valcesch/AstroTracker/hardware/AstroTracker_v06/STACKUP_astrotracker_v06_rev2.png

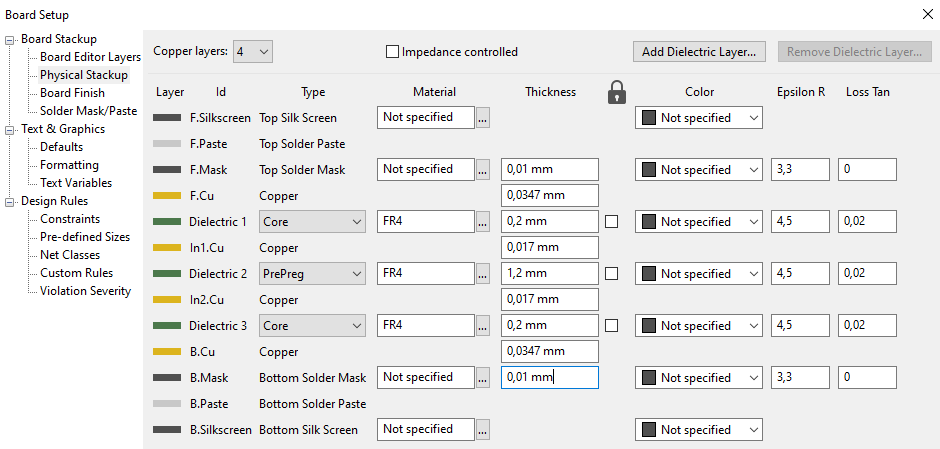
hardware/AstroTracker_v06/STACKUP_astrotracker_v06_rev2.png
