valcesch/AstroTracker/hardware/AstroTracker_v06/BOM_astrotracker_v06_rev2.xlsx

Designator | Manufacturer | Manufacturer reference | Value | Description | Package | Quantity | Unit cost | Total cost | Link
U1 | Guerrilla RF | GRF6011 | GRF6011 | RF Switch ICs .1-3.8GHz SPDT IL .43dB | SMD | 1 | 2.39 | 2.39 | https://www.mouser.ch/ProductDetail/Guerrilla-RF/GRF6011?qs=YCa%2FAAYMW03B6wCBu6EtGA%3D%3D
U2 | ublox | MAX-M10S | MAX-M10S | ublox GNSS receiver | SMD module | 1 | 20.67 | 20.67 | https://www.digikey.ch/de/products/detail/u-blox/MAX-M10S-00B/15712906
U3 | Astrocast | AST50147-00 | AST50147-00 | Astronode S | SMD module | 1 | 37 | 37
U4 | Astrocast | AST50127-00 | AST50127-00 | Astrocast antenna patch | Through hole pin | 1 | 5 | 5
U5 | Microchip | ATSAMD21G18A-M | ATSAMD21G18A-M | SAMD21 MCU | SMD | 1 | 3.91 | 3.91 | https://www.mouser.ch/ProductDetail/Microchip-Technology-Atmel/ATSAMD21G18A-MUT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
U6 | Microchip | MCP1700-3302E_SOT23 | MCP1700-3302E_SOT23 | Low Quiescent Current LDO | SMD | 1 | 0.465 | 0.465 | https://ww1.microchip.com/downloads/en/DeviceDoc/MCP1700-Low-Quiescent-Current-LDO-20001826E.pdf
U7 | Texas Instruments | TPL5010 | TPL5010 | Nano-Power System Timer With Watchdog Function | SMD | 1 | 1.17 | 1.17 | https://www.ti.com/lit/ds/symlink/tpl5010.pdf
C10,C11 | N.A. | N.A. | 22pF | 22pF 10% 25V Ceramic Capacitor X6S 0603 (1608 Metric) | 0603 | 2 | 0 | 0
C16,C19,C20 | N.A. | N.A. | 27pF | 27pF 10% 16V Ceramic Capacitor X7R 0402 (1005 Metric) | 402 | 3 | 0 | 0
C17,C18 | N.A. | N.A. | 100pF | 100pF 10% 16V Ceramic Capacitor X7R 0402 (1005 Metric) | 402 | 2 | 0 | 0
C8 | N.A. | N.A. | 0.1uF | 0.1uF 10% 25V Ceramic Capacitor X6S 0603 (1608 Metric) | 0603 | 1 | 0 | 0
C4,C6,C7,C12,C14,C15 | N.A. | N.A. | 1uF | 1uF 10% 25V Ceramic Capacitor X6S 0603 (1608 Metric) | 0603 | 6 | 0 | 0
C1,C2,C3,C13 | N.A. | N.A. | 10uF | 10uF 10% 10V Ceramic Capacitor X6S 0603 (1608 Metric) | 0603 | 4 | 0 | 0
R1,R2,R14 | N.A. | N.A. | 2.2k | 2.2 kOhms 1% 0.01W, 1/10W Chip Resistor 0603 (1608 Metric) Thick Film | 0603 | 3 | 0 | 0
R6,R7 | N.A. | N.A. | 22 | 22 Ohms 1% 0.01W, 1/10W Chip Resistor 0603 (1608 Metric) Thick Film | 0603 | 2 | 0 | 0
R12 | N.A. | N.A. | 47k | 47 kOhms 1% 0.01W, 1/10W Chip Resistor 0603 (1608 Metric) Thick Film | 0603 | 1 | 0 | 0
R11 | N.A. | N.A. | 100k | 100 kOhms 1% 0.01W, 1/10W Chip Resistor 0603 (1608 Metric) Thick Film | 0603 | 1 | 0 | 0
R3,R4,R9,R10,R13 | N.A. | N.A. | 1M | 1 MOhms 1% 0.01W, 1/10W Chip Resistor 0603 (1608 Metric) Thick Film | 0603 | 2 | 0 | 0
D2 | Vishay | VLMG1300-GS08 | VLMG1300-GS08 | Yellow LED 20mA 0603 (1608 Metric) Thick Film | 0603 | 1 | 0.29 | 0.29
D1 | Onsemi / Fairchild | MBR0530 | MBR0530 | Schottky Dioden & Gleichrichter Schottky diode 30V/0.5A | SOD-123-2 | 1 | 0.317 | 0.317 | https://www.mouser.ch/ProductDetail/onsemi-Fairchild/MBR0530?qs=VOMQJJE%252BBNniwJKcE3T43Q%3D%3D
Q1,Q3 | Vishay | SI2329DS-T1-GE3 | SI2329DS | P-Channel 8V 6A STO-23 | SOT-23 | 2 | 0.6 | 1.2
Q2 | Vishay | SI2342DS-T1-GE3 | SI2342DS | N-Channel 8V 6A STO-23 | SOT-23 | 1 | 0.6 | 0.6
SW2 | Diptronics | MPTFP2-V-T/R | MPTFP2-V-T/R | Tactile Switches | SMD | 1 | 0.7 | 0.7 | https://www.mouser.ch/ProductDetail/Diptronics/MPTFP2-V-T-R?qs=sGAEpiMZZMsqIr59i2oRckjEZjc1TSZQ1WwpmngjOl0%3D
J1 | Molex | 47346-0001 | 47346-0001 | USB Connectors MICRO USB B RECPT BTTM MOUNT ASSY | SMD | 1 | 1.08 | 1.08 | https://www.mouser.ch/ProductDetail/Molex/47346-0001?qs=c2CV6XM0DweJBWaSeyWeCw%3D%3D
J2 | SparkFun | PRT-08612 | PRT-08612 | SparkFun Accessories JST Right Angle Connector - White | SMD | 1 | 1 | 1 | https://www.mouser.ch/ProductDetail/SparkFun/PRT-08612?qs=WyAARYrbSnbBv6rnEOuhcA%3D%3D
Y1 | Abracon | ABS07-32.768KHZ-T | ABS07-32.768KHZ-T | Crystals 32.768K HZ 12.5PF SMD | SMD | 1 | 0.6 | 0.6 | https://www.mouser.ch/ProductDetail/ABRACON/ABS07-32.768KHZ-T?qs=3SpAxaLJ01g8GJWeO3sA3Q%3D%3D
