valcesch/AstroTracker/(threads)

Thread 1 (2023-10-12):

How to compile and upload firmware for AstroTracker V0.6 REV2 (MiniTracker)

Joaliasbarb, 2023-10-12:
Hello,

We are trying to compile and flash the firmware on a MiniTracker harwdare using Arduino IDE.
Unfortunately, the board description files for this hardware is not included in the repo and we didn't managed to create them. We're left with a lot of questions on how to proceed.

Could you provide us with some guidance on the necessary steps to perform ?

Cheers !

valcesch, 2023-10-12:
Hello Joaliasbarb,

When using the Arduino IDE, you need to select the Adafruit Feather M0. You will probably have to burn the bootloader for this platform (also with the Arduino IDE).

Hope this will solve your issue !

Closed 2023-11-10.
