valcesch/AstroTracker/hardware/AstroTracker_v06/SCHEMATIC_astrotracker_v06_rev2.pdf

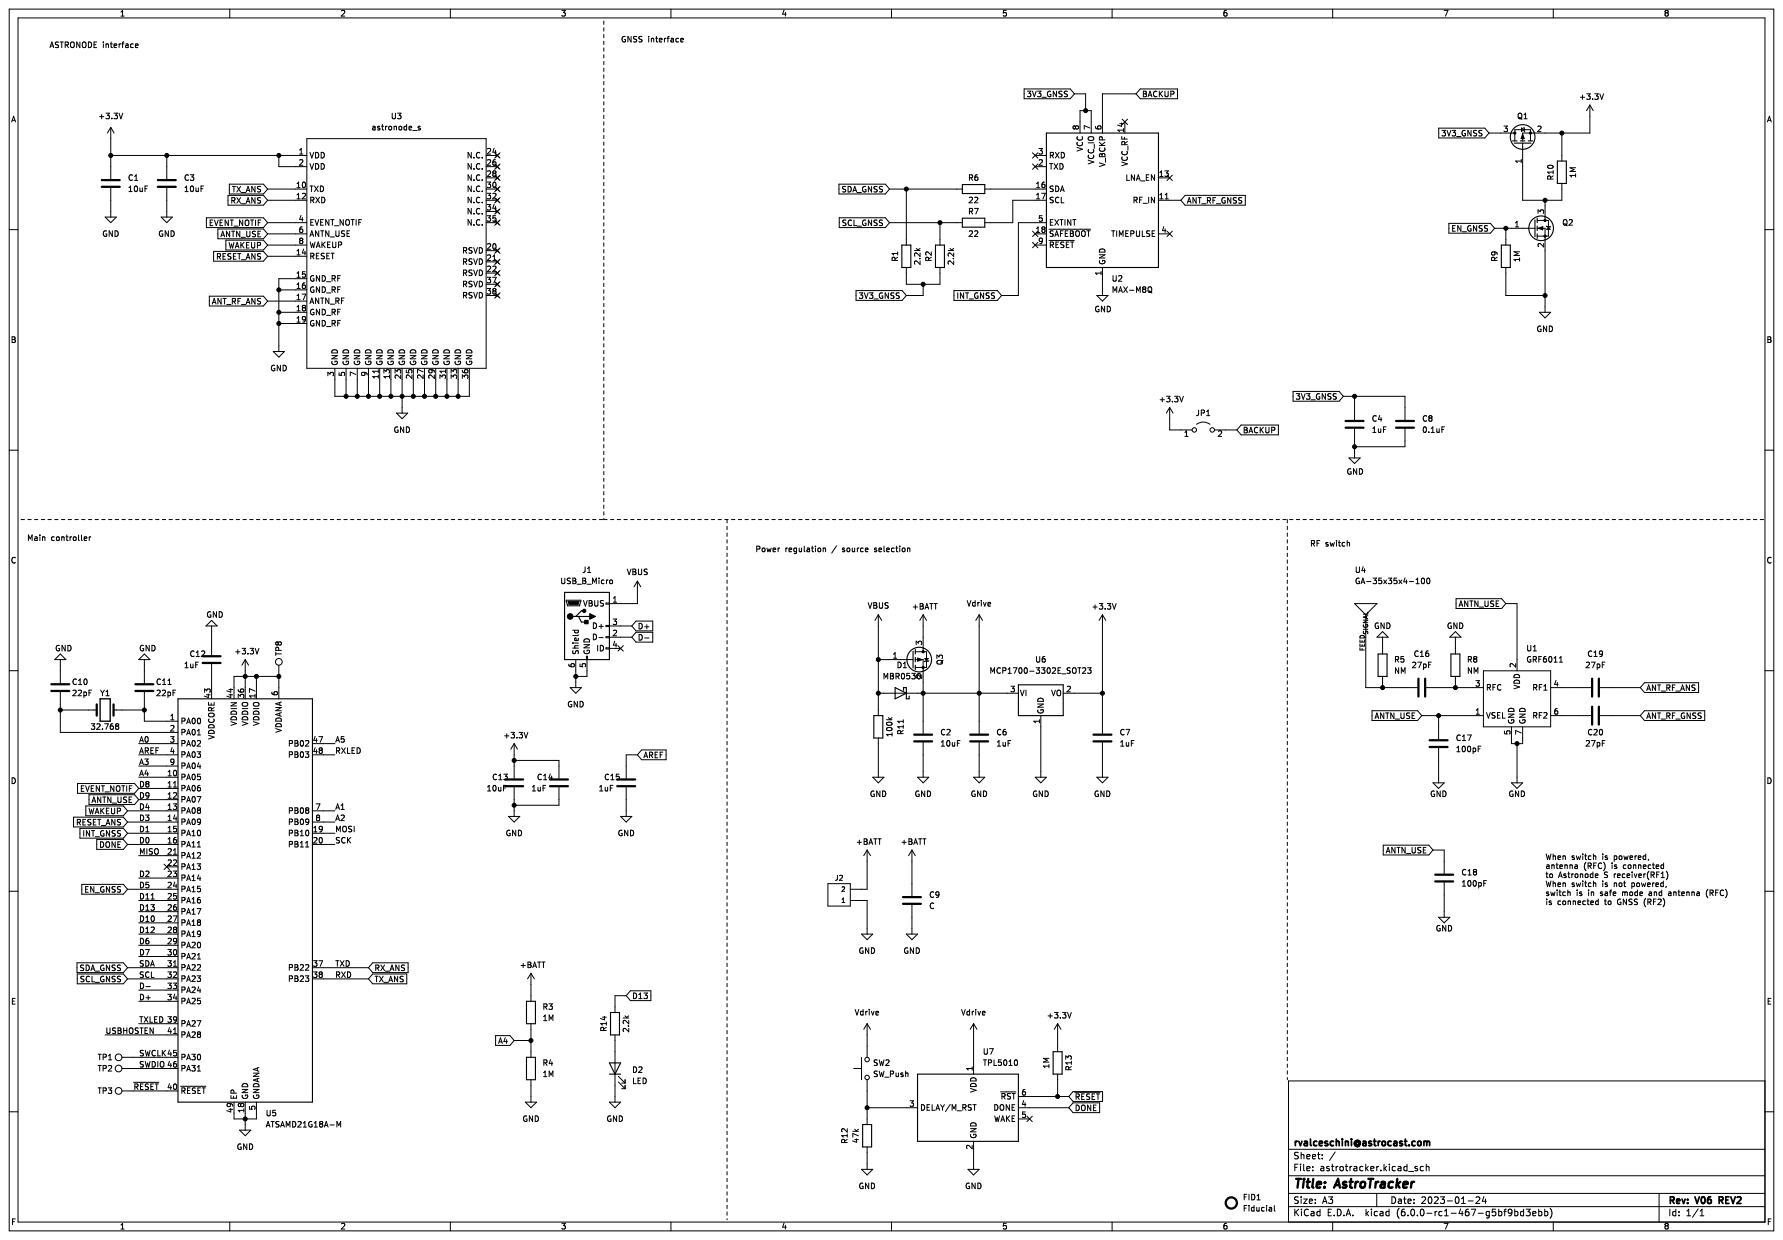
[picture p6: page 1]
