valcesch/AstroTracker/firmware/AstroTracker/src/core/sm/sm.cpp

/* sm.c - State machine handling code
 *
 * Copyright (C) 2018 Arribada
 *
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
 * You should have received a copy of the GNU General Public License
 * along with this program.  If not, see <https://www.gnu.org/licenses/>.
 */

#include "sm.h"
#include <limits.h>

#define FUNCTION_NOT_SET (INT_MAX)

void sm_init(sm_handle_t *handle, sm_state_func_t *state_table)
{
    handle->state_function_lookup_table = state_table;
    handle->last_state = FUNCTION_NOT_SET;
    handle->current_state = FUNCTION_NOT_SET;
    handle->next_state = FUNCTION_NOT_SET;
    handle->first_time_running = true;
}

void sm_tick(sm_handle_t *handle)
{
    handle->state_function_lookup_table[handle->current_state](handle);

    handle->first_time_running = false;

    if (handle->current_state != handle->next_state)
    {
        handle->first_time_running = true;
        handle->last_state = handle->current_state;
        handle->current_state = handle->next_state;
    }
};

bool sm_is_first_entry(const sm_handle_t *handle)
{
    return handle->first_time_running;
}

bool sm_is_last_entry(const sm_handle_t *handle)
{
    return sm_get_next_state(handle) != sm_get_current_state(handle);
}

void sm_set_next_state(sm_handle_t *handle, int state)
{
    if (FUNCTION_NOT_SET == handle->current_state)
        handle->current_state = state;

    handle->next_state = state;
}

int sm_get_last_state(const sm_handle_t *handle)
{
    return handle->last_state;
}

int sm_get_current_state(const sm_handle_t *handle)
{
    return handle->current_state;
}

int sm_get_next_state(const sm_handle_t *handle)
{
    return handle->next_state;
}
