valcesch/AstroTracker/firmware/AstroTracker/src/syshal/pmu/syshal_pmu.cpp

/******************************************************************************************
 * File:        syshal_pmu.cpp
 * Author:      valcesch
 * Compagny:    NA
 * Website:     https://github.com/valcesch/AstroTracker
 * E-mail:      NA
 *
 * AstroTracker
 * Copyright (C) 2023 valcesch
 *
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
 * You should have received a copy of the GNU Lesser General Public License
 * along with this program; if not, write to the Free Software Foundation,
 * Inc., 51 Franklin Street, Fifth Floor, Boston, MA  02110-1301, USA.
 ******************************************************************************************/

#include "../syshal_pmu.h"
#include "../syshal_rtc.h"
#include "../syshal_gpio.h"
#include "../syshal_time.h"
#include "../syshal_sat.h"
#include "../../core/debug/debug.h"
#include "../syshal_config.h"
#include <Wire.h>

#ifdef GPIO_HWDT_RESET
#define SYSHAL_PMU_GPIO_HWDT_RESET (GPIO_HWDT_RESET)
#endif

#define SYSHAL_PMU_HWDT_KICK_HTIME 1 //[us]

static uint32_t reset_reason;

/*
void syshal_pmu_assert_callback(uint16_t line_num, const uint8_t *file_name)
{
    syshal_rtc_stash_time();
#ifdef DONT_RESTART_ASSERT
    DEBUG_PR_ERROR("Assertion %s:%u", file_name, line_num);
    while (1)
    {
    }
#else
    NVIC_SystemReset();
#endif
}
*/

static volatile uint32_t _g_RTC_interrupt_interval = 0; // for periodic interrupts
static volatile voidFuncPtr _g_RTC_callBack = NULL;     // RTC interrupt user handler
static volatile bool _g_f_playing_possum = false;       // flag set by ISR to release spin loop

void syshal_pmu_init(void)
{
    syshal_gpio_init(SYSHAL_PMU_GPIO_HWDT_RESET, OUTPUT);

#if defined(NRF52_SERIES)
    // Empty
#elif defined(ARDUINO_ARCH_SAMD)
    // Empty
#endif
}

void syshal_pmu_sleep(syshal_pmu_sleep_mode_t mode)
{
    bool soft_wdt_running;
    int ret;
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
