valcesch/AstroTracker/(notices)

Notices in the files:
firmware/AstroTracker/src/syshal/gps/SparkFun_u-blox_GNSS_Arduino_Library.h:
SparkFun code, firmware, and software is released under the MIT License(http://opensource.org/licenses/MIT).
The MIT License (MIT)
Copyright (c) 2016 SparkFun Electronics
firmware/AstroTracker/src/core/sm/sm.cpp:
it under the terms of the GNU General Public License as published by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
